SSL-Roots/Circuit_BoostConverterBoard/BoostConverter - BoostConverter.pdf

Part | Value | 耐圧・電力 | Package | 購入先 | 単価
C100 | 1000uF | 25V | 10mm | 秋月電子 | ¥30.00
C101 | 47u | 25Ｖ | C3216 | RS | ¥148.00
C102 | 47u | 25Ｖ | C3216 | RS | ¥148.00
C103 | 47u | 25Ｖ | C3216 | RS | ¥148.00
C200 | 10u | 25Ｖ | C1608 | 秋月電子 | ¥15.00
C201 | 10u | 25Ｖ | C1608 | 秋月電子 | ¥15.00
C202 | 100p | 50V | 2.54㎜ | 秋月電子 | ¥5.00
C300 | 0.1u | 25Ｖ | C1608 | 秋月電子 | ¥2.00
C301 | 0.1u | 25Ｖ | C1608 | 秋月電子 | ¥2.00
C302 | 10u | 25Ｖ | C1608 | 秋月電子 | ¥15.00
C303 | 0.1u | 25Ｖ | C1608 | 秋月電子 | ¥2.00
C304 | 10u | 25Ｖ | C1608 | 秋月電子 | ¥15.00
C305 | 0.1u | 25Ｖ | C1608 | 秋月電子 | ¥2.00
C306 | 100u | 25Ｖ | 5mm | 秋月電子 | ¥10.00
C307 | 0.1u | 25Ｖ | C1608 | 秋月電子 | ¥2.00
D300 | STTH506B | - | DPAK | DigiKey | ¥141.10
D301 | STTH506B | - | DPAK | DigiKey | ¥141.10
D302 | STTH506B | - | DPAK | DigiKey | ¥141.10
IC200 | LT3750 | - | MSOP10 | DigiKey | ¥844.00
IC300 | ADUM5230 | - | SOIC-16 | DigiKey | ¥743.00
IC301 | TC4427 | - | SOIC-8 | DigiKey | ¥140.00
LED100 | OSG5DA3133A | - | LED3MM | 秋月電子 | ¥4.50
LED101 | OSDR3133A | - | LED3MM | 秋月電子 | ¥3.50
LED102 | OSUB3131A | - | LED3MM | 秋月電子 | ¥15.00
LED300 | OSG5DA3133A | - | LED3MM | 秋月電子 | ¥4.50
Q100 | 2SC2712 | - | TO23 | 秋月電子 | ¥5.00
Q200 | NTD6414ANT4G | - | TO-252 | RS | ¥143.50
Q300 | IGB50N60T | - | D2PACK | DigiKey | ¥574.00
Q301 | IGB50N60T | - | D2PACK | DigiKey | ¥574.00
R100 | 1k | 1/10W | R1608 | 秋月電子 | ¥0.20
R101 | 1k | 1/10W | R1608 | 秋月電子 | ¥0.20
R102 | 1k | 1/10W | R1608 | 秋月電子 | ¥0.20
R103 | 100k | 1/10W | R1608 | 秋月電子 | ¥0.20
R104 | 100k | 1/10W | R1608 | 秋月電子 | ¥0.20
R200 | 100k | 1/10W | R1608 | 秋月電子 | ¥0.20
R201 | 1k | 1/10W | R1608 | 秋月電子 | ¥0.20
R202 | 2.4k | 1/4W | 0204/5S | 秋月電子 | ¥1.00
R203 | 10 | 1/10W | R1608 | 秋月電子 | ¥0.20
R204 | 100ｋ | 1/10W | R1608 | 秋月電子 | ¥0.20
R300 | 100ｋ | 1/10W | R1608 | 秋月電子 | ¥0.20
R301 | 100ｋ | 1/10W | R1608 | 秋月電子 | ¥0.20
R302 | 10ｋ | 1/10W | R1608 | 秋月電子 | ¥0.20
R303 | 10ｋ | 1/10W | R1608 | 秋月電子 | ¥0.20
R304 | 100k | 1/10W | R1608 | 秋月電子 | ¥0.20
R305 | 100k | 1/10W | R1608 | 秋月電子 | ¥0.20

R306 | 100 | 1/10W | R1608 | 秋月電子 | ¥0.20
R307 | 100 | 1/10W | R1608 | 秋月電子 | ¥0.20
R308 | 1k | 1/10W | R1608 | 秋月電子 | ¥0.20
R309 | 1k | 1/10W | R1608 | 秋月電子 | ¥0.20
R400 | 使用しません | - | R-US_R1608 | - | -
R401 | 使用しません | - | R-US_R1608 | - | -
RDCM | 39k | 1/4W | 0204/7 | 秋月電子 | ¥1.00
RSENSE1 | 8m 1% | 1W | M3216 | DigiKey | ¥86.30
RVOUT | 33k | 1/4W | 0204/7 | 秋月電子 | ¥1.00
SOL1 | 2pin | - | 22-05-3021-NH | RS | ¥24.70
SOL2 | 2pin | - | 22-05-3021-NH | RS | ¥24.70
T1 | 32052 | - | - | DigiKey | ¥1,221.00
CON100 | B12B-XASK-1 | - | XA12pin | RS | ¥96.10
VR1 | 5k | - | 3296W | 秋月電子 | ¥80.00
ZD200 | 1SMA5931BT3G | - | DO214AC | RS | ¥35.30
基板 | - | - | - | elecrow | ¥108.40
| | | | 合計 | ¥5,716.60
