SSL-Roots/Circuit_BoostConverterBoard/回路図/Ver.2.1.brd

## EAGLE design 回路図/Ver.2.1.brd (2017-08-02)

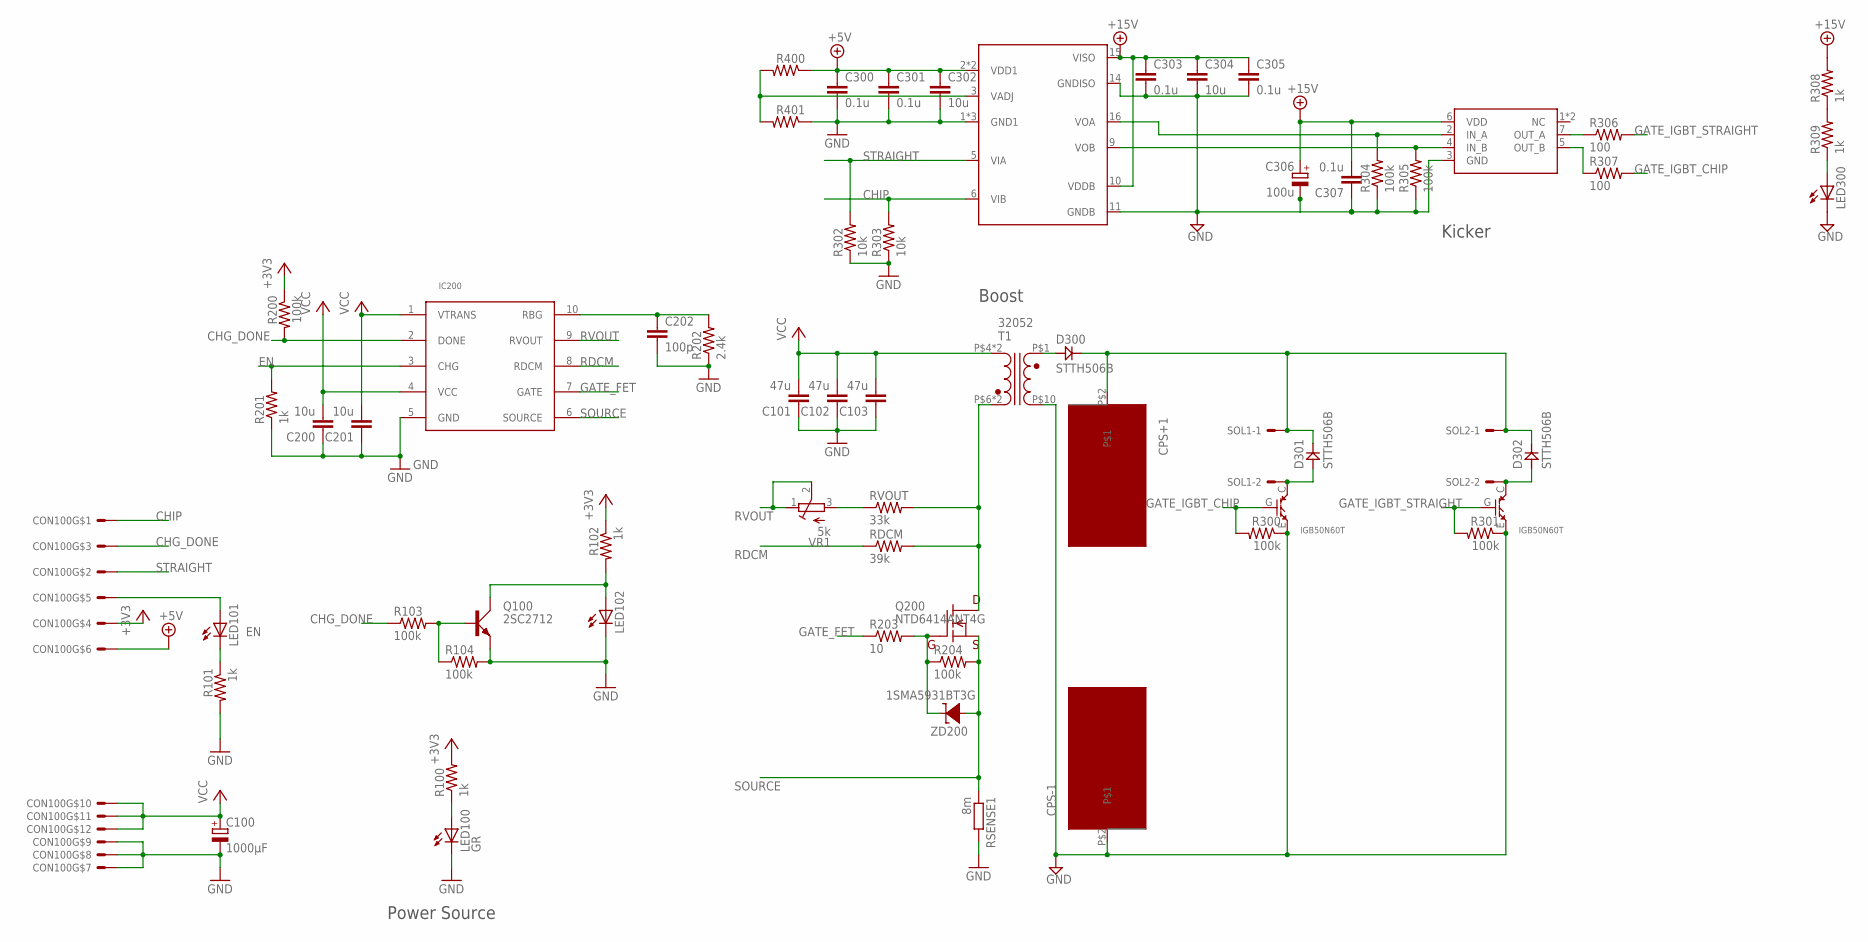
[picture p1: schematic Ver.2.1.sch]

Parts:
C100: 1000μF; E5-10
C101, C102, C103: 47u; C3216
C200, C201, C302, C304: 10u; C1608
C202: 100p; C5B5.5
C300, C301, C303, C305, C307: 0.1u; C1608
C306: 100u; E2,5-6
CON100: 12B-XH-AB12B; B12B-XH-A
CPS+1: POWER_SOURCE_PAD
CPS-1: POWER_SOURCE_PAD
D300, D301, D302: STTH506B; DPAK
IC200: LT3750; MSOP10
IC300: ADUM5230; SOIC-16
IC301: TC4427; SOIC-8
LED100: GR; LED3MM
LED101, LED102, LED300: LED3MM
Q100: 2SC2712; TO23
Q200: NTD6414ANT4G; TO-252
Q300, Q301: IGB50N60T; D2PACK
R100, R101, R102, R201, R308, R309: 1k; R1608
R103, R104, R200, R204, R300, R301, R304, R305: 100k; R1608
R202: 2.4k; 0204/5S
R203: 10; 0204/7
R302, R303: 10k; R1608
R306, R307: 100; R1608
R400, R401: R-US_R1608; R1608
RDCM: 39k; 0204/7
RSENSE1: 8m; M3216
RVOUT: 33k; 0204/7
SOL1, SOL2: KK-156-2-RA-NH; 22-05-3021-NH
T1: 32052
VR1: 5k; RTRIM64W_S
ZD200: 1SMA5931BT3G; DO214AC

Connections:
200: CPS+1.P$2, D300.K, D301.K, D302.K, SOL1.1, SOL2.1
+3V3: CON100.4, R100.2, R102.1, R200.1
+5V: C300.1, C301.1, C302.1, CON100.6, IC300.2 (VDD1), IC300.7 (VDD1), R400.1
+15V: C303.1, C304.1, C305.1, C306.+, C307.2, IC300.10 (VDDB), IC300.15 (VISO), IC301.6 (VDD), R308.2
CHG_DONE: CON100.3, IC200.2 (DONE), R103.1, R200.2
CHIP: CON100.1, IC300.6 (VIB), R303.2
C_GND: C303.2, C304.2, C305.2, C306.-, C307.1, CPS-1.P$2, IC300.11 (GNDB), IC300.14 (GNDISO), IC301.3 (GND), LED300.K (C), Q300.E, Q301.E, R300.1, R301.1, R304.1, R305.1, T1.P$10 (4)
EN: CON100.5, IC200.3 (CHG), LED101.A, R201.2
GATE_FET: IC200.7 (GATE), R203.1
GATE_IGBT_CHIP: Q300.G, R300.2, R307.2
GATE_IGBT_STRAIGHT: Q301.G, R301.2, R306.2
GND: C100.-, C101.1, C102.1, C103.1, C200.1, C201.1, C202.2, C300.2, C301.2, C302.2, CON100.7, CON100.8, CON100.9, IC200.5 (GND), IC300.1 (GND1), IC300.4 (GND1), IC300.8 (GND1), LED100.K (C), LED102.K (C), Q100.E, R101.2, R104.2, R201.1, R202.1, R302.1, R303.1, R401.1, RSENSE1.2
unnamed: LED100.A, R100.1
unnamed: Q200.D, RDCM.2, RVOUT.2, T1.P$6 (2), T1.P$7 (2)
unnamed: Q200.G, R203.2, R204.1, ZD200.C (K)
unnamed: RVOUT.1, VR1.3 (E)
unnamed: D300.A, T1.P$1 (3)
unnamed: D301.A, Q300.C, SOL1.2
unnamed: D302.A, Q301.C, SOL2.2
unnamed: Q100.B, R103.2, R104.1
unnamed: LED300.A, R309.1
unnamed: C202.1, IC200.10 (RBG), R202.2
unnamed: LED102.A, Q100.C, R102.2
unnamed: IC300.9 (VOB), IC301.4 (IN_B), R305.2
unnamed: IC300.16 (VOA), IC301.2 (IN_A), R304.2
unnamed: IC300.3 (VADJ), R400.2, R401.2
unnamed: R308.1, R309.2
unnamed: IC301.7 (OUT_A), R306.1
unnamed: IC301.5 (OUT_B), R307.1
unnamed: LED101.K (C), R101.1
RDCM: IC200.8 (RDCM), RDCM.1
RVOUT: IC200.9 (RVOUT), VR1.1 (A), VR1.2 (S)
SOURCE: IC200.6 (SOURCE), Q200.S, R204.2, RSENSE1.1, ZD200.A
STRAIGHT: CON100.2, IC300.5 (VIA), R302.2
VCC: C100.+, C101.2, C102.2, C103.2, C200.2, C201.2, CON100.10, CON100.11, CON100.12, IC200.1 (VTRANS), IC200.4 (VCC), T1.P$4 (1), T1.P$5 (1)

Notes on the sheet:
Power Source
Boost
Kicker

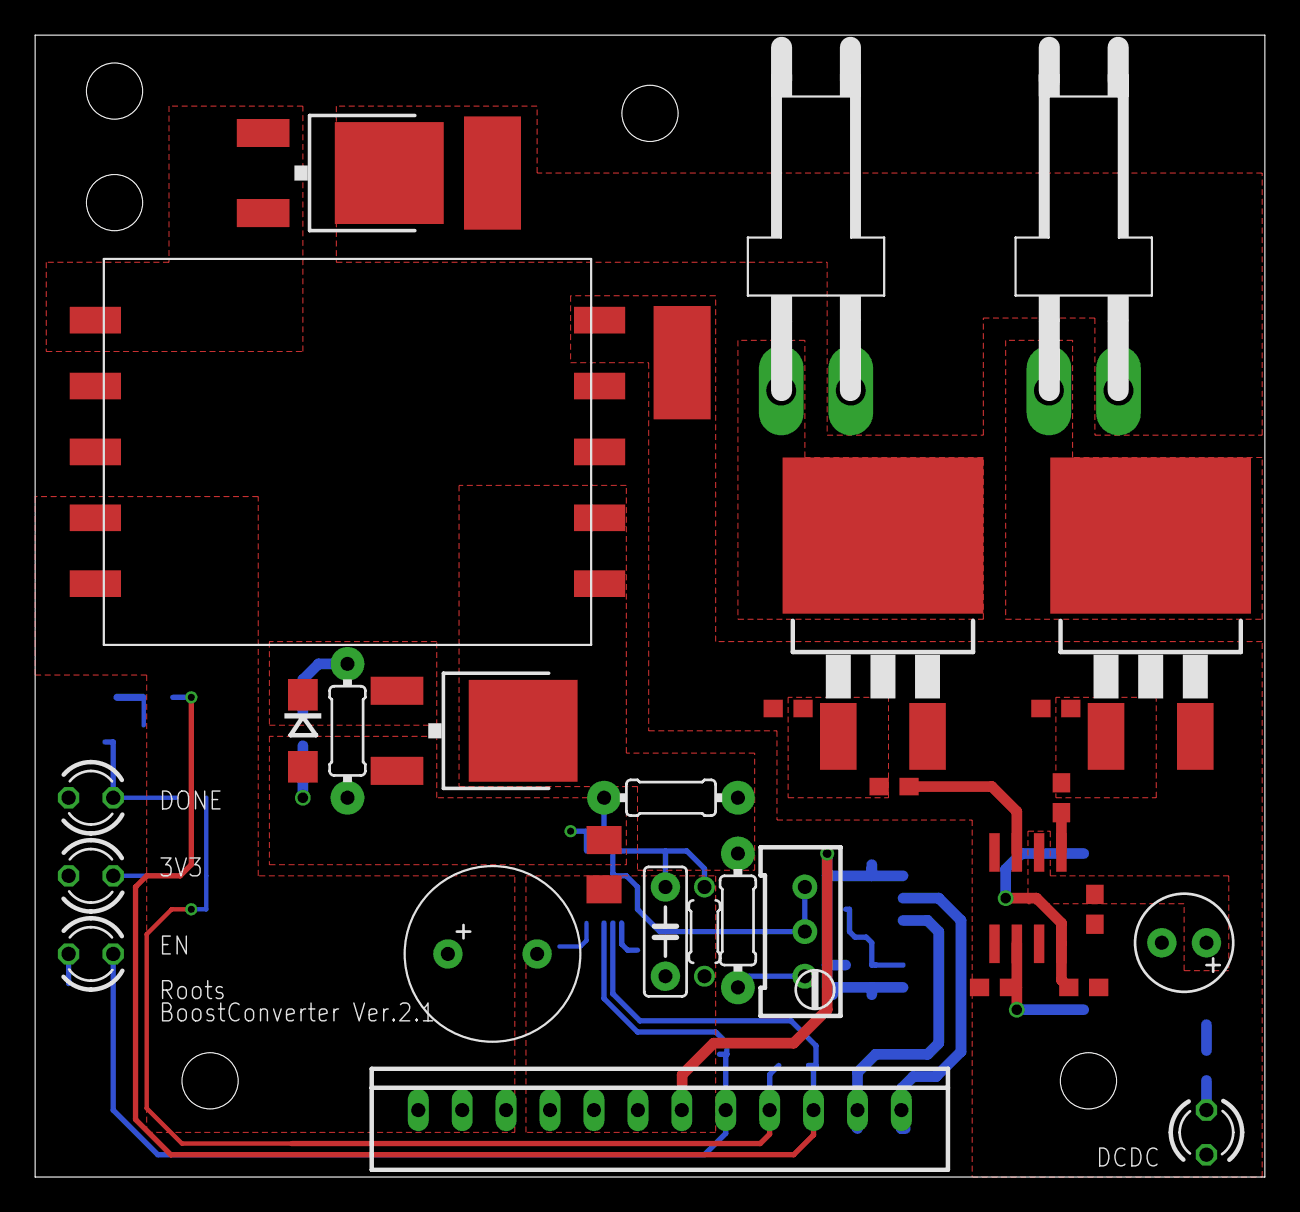
[picture p2: board Ver.2.1.brd from above]

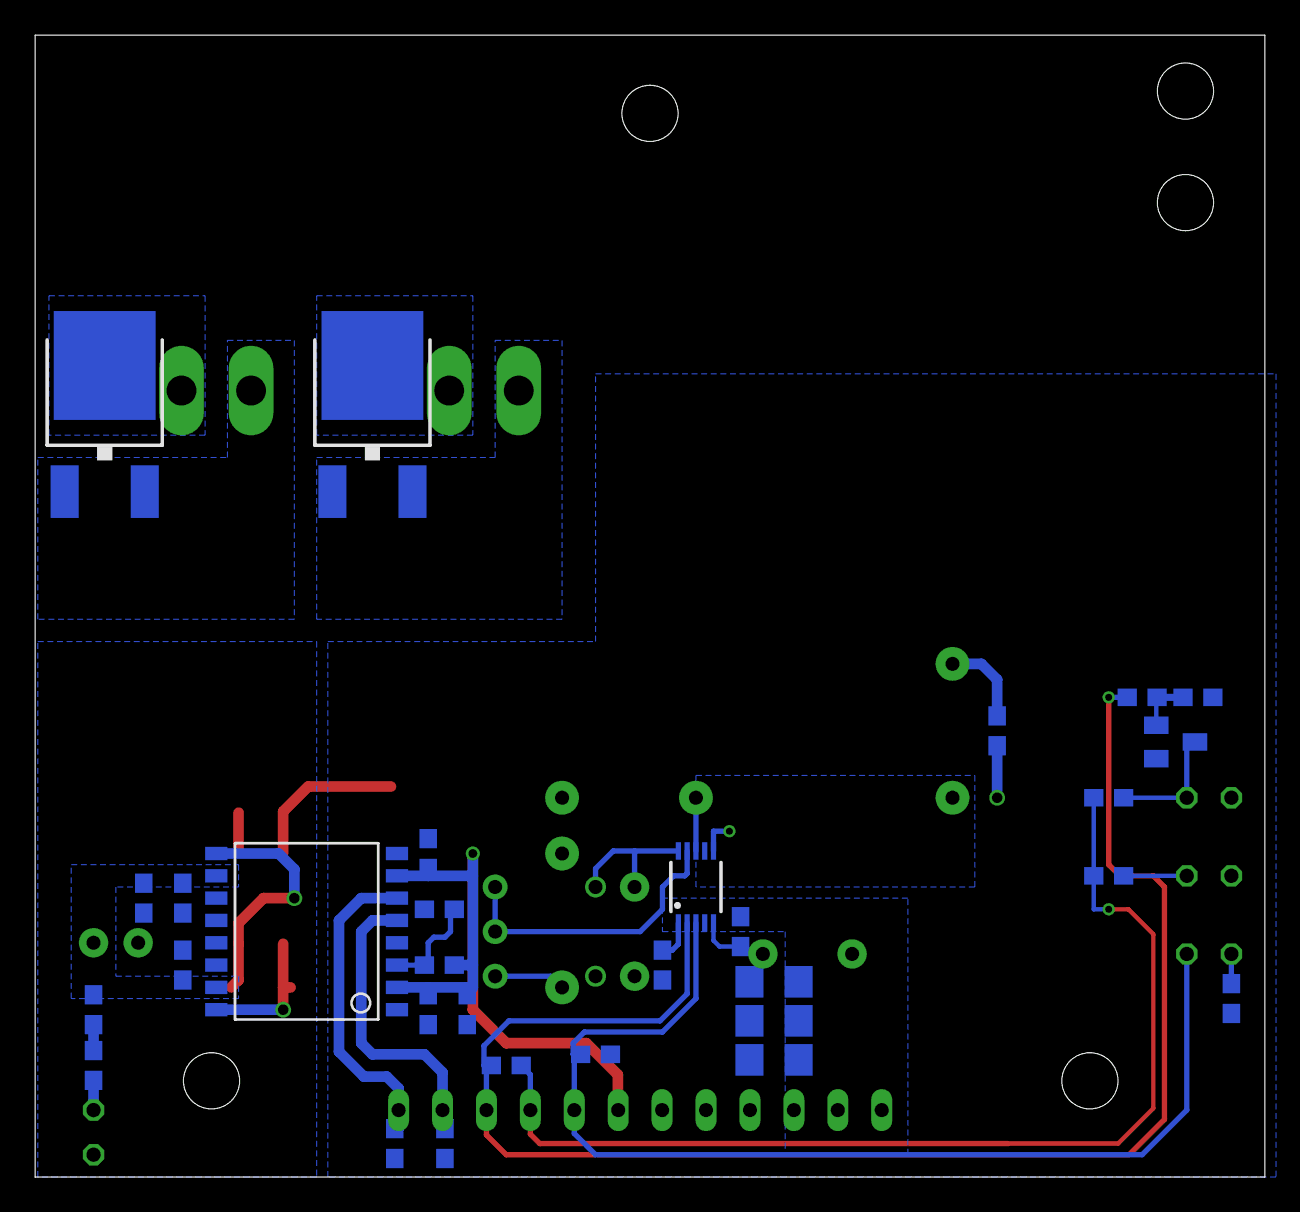
[picture p3: board Ver.2.1.brd from below]

Board: 2 copper layers, 70.0 x 65.0 mm, 62 parts (30 on the bottom side), 35 nets.
